makreed-dt/PLFM_RADAR/9_Firmware/9_2_FPGA/cic_decimator_4x_enhanced.v

module cic_decimator_4x_enhanced (
    input wire clk,                 // 400MHz input clock
    input wire reset_n,
    input wire signed [17:0] data_in,  // 18-bit input
    input wire data_valid,
    output reg signed [17:0] data_out, // 18-bit output
    output reg data_out_valid,       // Valid at 100MHz
    // Enhanced monitoring outputs
    output reg saturation_detected,  // Latched saturation indicator
    output reg [7:0] max_value_monitor, // For gain control
    input wire reset_monitors        // Clear saturation and max value
);

parameter STAGES = 5;
parameter DECIMATION = 4;
parameter COMB_DELAY = 1;

// Accumulator width: DSP48E1 native 48-bit.
// CIC uses modular (wrapping) arithmetic so extra MSBs are harmless.
localparam ACC_WIDTH = 48;

// Comb section operates on 28-bit (18 + 5*log2(4) = 28, exact for comb range).
localparam COMB_WIDTH = 28;

// ============================================================================
// INTEGRATOR CHAIN — explicit DSP48E1 with PCOUT→PCIN cascade
// ============================================================================
// Integrator[0]: P = P + C,    C = sign_extend(data_in)  [from fabric]
// Integrator[k]: P = P + PCIN, PCIN from integrator[k-1] [dedicated cascade]
//
// The PCOUT→PCIN cascade uses dedicated silicon routing between vertically
// adjacent DSP48E1 tiles — zero fabric delay, guaranteed to meet 400+ MHz
// on 7-series regardless of speed grade.
//
// Active-high reset derived from reset_n (inverted).
// CEP (clock enable for P register) gated by data_valid.
// ============================================================================

wire reset_h = ~reset_n;  // active-high reset for DSP48E1 RSTP

// Sign-extended input for integrator_0 C port (48-bit)
wire [ACC_WIDTH-1:0] data_in_c = {{(ACC_WIDTH-18){data_in[17]}}, data_in};

// DSP48E1 cascade wires
wire [47:0] pcout_0, pcout_1, pcout_2, pcout_3;
wire [47:0] p_out_0, p_out_1, p_out_2, p_out_3, p_out_4;

`ifndef SIMULATION
// ============================================================================
// SYNTHESIS: Explicit DSP48E1 instances with PCOUT→PCIN cascade
// ============================================================================

// --- Integrator 0: P = P + C (accumulate sign-extended input) ---
// OPMODE = 7'b0101100: Z=P(010), Y=C(11), X=0(00) → P = P + C
// CREG=1: C port is registered inside DSP48E1. This eliminates the
// fabric→DSP C-port setup timing violation (-0.415ns in Build 6).
// The CREG adds 1 cycle of latency before data reaches the ALU.
// CEC=data_valid gates the C register to match CEP behavior.
DSP48E1 #(
    .A_INPUT            ("DIRECT"),
    .B_INPUT            ("DIRECT"),
    .USE_DPORT          ("FALSE"),
    .USE_MULT           ("NONE"),
    .AUTORESET_PATDET   ("NO_RESET"),
    .MASK               (48'h3FFFFFFFFFFF),
    .PATTERN             (48'h000000000000),
    .SEL_MASK           ("MASK"),
    .SEL_PATTERN        ("PATTERN"),
    .USE_PATTERN_DETECT ("NO_PATDET"),
    .ACASCREG           (0),
    .ADREG              (0),
    .ALUMODEREG         (0),
    .AREG               (0),
    .BCASCREG           (0),
    .BREG               (0),
    .CARRYINREG         (0),
    .CARRYINSELREG      (0),
    .CREG               (1),       // C port registered inside DSP — eliminates fabric→DSP setup path
    .DREG               (0),
    .INMODEREG          (0),
    .MREG               (0),
    .OPMODEREG          (0),
    .PREG               (1)        // P register enabled (accumulator)
) integrator_0_dsp (
    .CLK                (clk),
    .A                  (30'd0),
    .B                  (18'd0),
    .C                  (data_in_c),
    .D                  (25'd0),
    .CARRYIN            (1'b0),
    .CARRYINSEL         (3'b000),
    .OPMODE             (7'b0101100),  // P = P + C
    .ALUMODE            (4'b0000),     // Z + (X + Y + CIN)
    .INMODE             (5'b00000),
    .CEA1               (1'b0),
    .CEA2               (1'b0),
    .CEB1               (1'b0),
    .CEB2               (1'b0),
    .CEC                (data_valid),  // Register C when data is valid (CREG=1)
    .CED                (1'b0),
    .CEM                (1'b0),
    .CEP                (data_valid),  // Accumulate only when data is valid
    .CEAD               (1'b0),
    .CEALUMODE          (1'b0),
    .CECTRL             (1'b0),
    .CECARRYIN          (1'b0),
    .CEINMODE           (1'b0),
    .RSTP               (reset_h),
    .RSTA               (1'b0),
    .RSTB               (1'b0),
    .RSTC               (reset_h),     // Reset C register (CREG=1) on reset
    .RSTD               (1'b0),
    .RSTM               (1'b0),
    .RSTALLCARRYIN      (1'b0),
    .RSTALUMODE         (1'b0),
    .RSTCTRL            (1'b0),
    .RSTINMODE          (1'b0),
    .P                  (p_out_0),
    .PCOUT              (pcout_0),
    .ACOUT              (),
    .BCOUT              (),
    .CARRYCASCOUT       (),
    .CARRYOUT           (),
    .MULTSIGNOUT        (),
    .OVERFLOW           (),
    .PATTERNBDETECT     (),
    .PATTERNDETECT      (),
    .UNDERFLOW          ()
);

// --- Integrator 1: P = P + PCIN (cascade from integrator_0) ---
// OPMODE = 7'b0010010: Z=PCIN(001), Y=0(00), X=P(10) → P = P + PCIN
DSP48E1 #(
    .A_INPUT            ("DIRECT"),
    .B_INPUT            ("DIRECT"),
    .USE_DPORT          ("FALSE"),
    .USE_MULT           ("NONE"),
    .AUTORESET_PATDET   ("NO_RESET"),
    .MASK               (48'h3FFFFFFFFFFF),
    .PATTERN             (48'h000000000000),
    .SEL_MASK           ("MASK"),
    .SEL_PATTERN        ("PATTERN"),
    .USE_PATTERN_DETECT ("NO_PATDET"),
    .ACASCREG           (0),
    .ADREG              (0),
    .ALUMODEREG         (0),
    .AREG               (0),
    .BCASCREG           (0),
    .BREG               (0),
    .CARRYINREG         (0),
    .CARRYINSELREG      (0),
    .CREG               (0),
    .DREG               (0),
    .INMODEREG          (0),
    .MREG               (0),
    .OPMODEREG          (0),
    .PREG               (1)
) integrator_1_dsp (
    .CLK                (clk),
    .A                  (30'd0),
    .B                  (18'd0),
    .C                  (48'd0),
    .D                  (25'd0),
    .PCIN               (pcout_0),
    .CARRYIN            (1'b0),
    .CARRYINSEL         (3'b000),
    .OPMODE             (7'b0010010),  // P = P + PCIN
    .ALUMODE            (4'b0000),
    .INMODE             (5'b00000),
    .CEA1               (1'b0),
    .CEA2               (1'b0),
    .CEB1               (1'b0),
    .CEB2               (1'b0),
    .CEC                (1'b0),
    .CED                (1'b0),
    .CEM                (1'b0),
    .CEP                (data_valid),
    .CEAD               (1'b0),
    .CEALUMODE          (1'b0),
    .CECTRL             (1'b0),
    .CECARRYIN          (1'b0),
    .CEINMODE           (1'b0),
    .RSTP               (reset_h),
    .RSTA               (1'b0),
    .RSTB               (1'b0),
    .RSTC               (1'b0),
    .RSTD               (1'b0),
    .RSTM               (1'b0),
    .RSTALLCARRYIN      (1'b0),
    .RSTALUMODE         (1'b0),
    .RSTCTRL            (1'b0),
    .RSTINMODE          (1'b0),
    .P                  (p_out_1),
    .PCOUT              (pcout_1),
    .ACOUT              (),
    .BCOUT              (),
    .CARRYCASCOUT       (),
    .CARRYOUT           (),
    .MULTSIGNOUT        (),
    .OVERFLOW           (),
    .PATTERNBDETECT     (),
    .PATTERNDETECT      (),
    .UNDERFLOW          ()
);

// --- Integrator 2: P = P + PCIN (cascade from integrator_1) ---
DSP48E1 #(
    .A_INPUT            ("DIRECT"),
    .B_INPUT            ("DIRECT"),
    .USE_DPORT          ("FALSE"),
    .USE_MULT           ("NONE"),
    .AUTORESET_PATDET   ("NO_RESET"),
    .MASK               (48'h3FFFFFFFFFFF),
    .PATTERN             (48'h000000000000),
    .SEL_MASK           ("MASK"),
    .SEL_PATTERN        ("PATTERN"),
    .USE_PATTERN_DETECT ("NO_PATDET"),
    .ACASCREG           (0),
    .ADREG              (0),
    .ALUMODEREG         (0),
    .AREG               (0),
    .BCASCREG           (0),
    .BREG               (0),
    .CARRYINREG         (0),
    .CARRYINSELREG      (0),
    .CREG               (0),
    .DREG               (0),
    .INMODEREG          (0),
    .MREG               (0),
    .OPMODEREG          (0),
    .PREG               (1)
) integrator_2_dsp (
    .CLK                (clk),
    .A                  (30'd0),
    .B                  (18'd0),
    .C                  (48'd0),
    .D                  (25'd0),
    .PCIN               (pcout_1),
    .CARRYIN            (1'b0),
    .CARRYINSEL         (3'b000),
    .OPMODE             (7'b0010010),  // P = P + PCIN
    .ALUMODE            (4'b0000),
    .INMODE             (5'b00000),
    .CEA1               (1'b0),
    .CEA2               (1'b0),
    .CEB1               (1'b0),
    .CEB2               (1'b0),
    .CEC                (1'b0),
    .CED                (1'b0),
    .CEM                (1'b0),
    .CEP                (data_valid),
    .CEAD               (1'b0),
    .CEALUMODE          (1'b0),
    .CECTRL             (1'b0),
    .CECARRYIN          (1'b0),
    .CEINMODE           (1'b0),
    .RSTP               (reset_h),
    .RSTA               (1'b0),
    .RSTB               (1'b0),
    .RSTC               (1'b0),
    .RSTD               (1'b0),
    .RSTM               (1'b0),
    .RSTALLCARRYIN      (1'b0),
    .RSTALUMODE         (1'b0),
    .RSTCTRL            (1'b0),
    .RSTINMODE          (1'b0),
    .P                  (p_out_2),
    .PCOUT              (pcout_2),
    .ACOUT              (),
    .BCOUT              (),
    .CARRYCASCOUT       (),
    .CARRYOUT           (),
    .MULTSIGNOUT        (),
    .OVERFLOW           (),
    .PATTERNBDETECT     (),
    .PATTERNDETECT      (),
    .UNDERFLOW          ()
);

// --- Integrator 3: P = P + PCIN (cascade from integrator_2) ---
DSP48E1 #(
    .A_INPUT            ("DIRECT"),
    .B_INPUT            ("DIRECT"),
    .USE_DPORT          ("FALSE"),
    .USE_MULT           ("NONE"),
    .AUTORESET_PATDET   ("NO_RESET"),
    .MASK               (48'h3FFFFFFFFFFF),
    .PATTERN             (48'h000000000000),
    .SEL_MASK           ("MASK"),
    .SEL_PATTERN        ("PATTERN"),
    .USE_PATTERN_DETECT ("NO_PATDET"),
    .ACASCREG           (0),
    .ADREG              (0),
    .ALUMODEREG         (0),
    .AREG               (0),
    .BCASCREG           (0),
    .BREG               (0),
    .CARRYINREG         (0),
    .CARRYINSELREG      (0),
    .CREG               (0),
    .DREG               (0),
    .INMODEREG          (0),
    .MREG               (0),
    .OPMODEREG          (0),
    .PREG               (1)
) integrator_3_dsp (
    .CLK                (clk),
    .A                  (30'd0),
    .B                  (18'd0),
    .C                  (48'd0),
    .D                  (25'd0),
    .PCIN               (pcout_2),
    .CARRYIN            (1'b0),
    .CARRYINSEL         (3'b000),
    .OPMODE             (7'b0010010),  // P = P + PCIN
    .ALUMODE            (4'b0000),
    .INMODE             (5'b00000),
    .CEA1               (1'b0),
    .CEA2               (1'b0),
    .CEB1               (1'b0),
    .CEB2               (1'b0),
    .CEC                (1'b0),
    .CED                (1'b0),
    .CEM                (1'b0),
    .CEP                (data_valid),
    .CEAD               (1'b0),
    .CEALUMODE          (1'b0),
    .CECTRL             (1'b0),
    .CECARRYIN          (1'b0),
    .CEINMODE           (1'b0),
    .RSTP               (reset_h),
    .RSTA               (1'b0),
    .RSTB               (1'b0),
    .RSTC               (1'b0),
    .RSTD               (1'b0),
    .RSTM               (1'b0),
    .RSTALLCARRYIN      (1'b0),
    .RSTALUMODE         (1'b0),
    .RSTCTRL            (1'b0),
    .RSTINMODE          (1'b0),
    .P                  (p_out_3),
    .PCOUT              (pcout_3),
    .ACOUT              (),
    .BCOUT              (),
    .CARRYCASCOUT       (),
    .CARRYOUT           (),
    .MULTSIGNOUT        (),
    .OVERFLOW           (),
    .PATTERNBDETECT     (),
    .PATTERNDETECT      (),
    .UNDERFLOW          ()
);

// --- Integrator 4: P = P + PCIN (cascade from integrator_3) ---
// No PCOUT needed (last stage in cascade)
DSP48E1 #(
    .A_INPUT            ("DIRECT"),
    .B_INPUT            ("DIRECT"),
    .USE_DPORT          ("FALSE"),
    .USE_MULT           ("NONE"),
    .AUTORESET_PATDET   ("NO_RESET"),
    .MASK               (48'h3FFFFFFFFFFF),
    .PATTERN             (48'h000000000000),
    .SEL_MASK           ("MASK"),
    .SEL_PATTERN        ("PATTERN"),
    .USE_PATTERN_DETECT ("NO_PATDET"),
    .ACASCREG           (0),
    .ADREG              (0),
    .ALUMODEREG         (0),
    .AREG               (0),
    .BCASCREG           (0),
    .BREG               (0),
    .CARRYINREG         (0),
    .CARRYINSELREG      (0),
    .CREG               (0),
    .DREG               (0),
    .INMODEREG          (0),
    .MREG               (0),
    .OPMODEREG          (0),
    .PREG               (1)
) integrator_4_dsp (
    .CLK                (clk),
    .A                  (30'd0),
    .B                  (18'd0),
    .C                  (48'd0),
    .D                  (25'd0),
    .PCIN               (pcout_3),
    .CARRYIN            (1'b0),
    .CARRYINSEL         (3'b000),
    .OPMODE             (7'b0010010),  // P = P + PCIN
    .ALUMODE            (4'b0000),
    .INMODE             (5'b00000),
    .CEA1               (1'b0),
    .CEA2               (1'b0),
    .CEB1               (1'b0),
    .CEB2               (1'b0),
    .CEC                (1'b0),
    .CED                (1'b0),
    .CEM                (1'b0),
    .CEP                (data_valid),
    .CEAD               (1'b0),
    .CEALUMODE          (1'b0),
    .CECTRL             (1'b0),
    .CECARRYIN          (1'b0),
    .CEINMODE           (1'b0),
    .RSTP               (reset_h),
    .RSTA               (1'b0),
    .RSTB               (1'b0),
    .RSTC               (1'b0),
    .RSTD               (1'b0),
    .RSTM               (1'b0),
    .RSTALLCARRYIN      (1'b0),
    .RSTALUMODE         (1'b0),
    .RSTCTRL            (1'b0),
    .RSTINMODE          (1'b0),
    .P                  (p_out_4),
    .PCOUT              (),
    .ACOUT              (),
    .BCOUT              (),
    .CARRYCASCOUT       (),
    .CARRYOUT           (),
    .MULTSIGNOUT        (),
    .OVERFLOW           (),
    .PATTERNBDETECT     (),
    .PATTERNDETECT      (),
    .UNDERFLOW          ()
);

`else
// ============================================================================
// SIMULATION: Behavioral model (Icarus Verilog compatible)
// ============================================================================
// Functionally identical: each integrator is P <= P + input, gated by data_valid.
// integrator_0 adds sign-extended data_in; stages 1-4 add previous stage output.
//
// CREG=1 on integrator_0: The C-port register adds 1 cycle of latency.
// data_in_c_delayed models this: on cycle N with data_valid, the DSP's C register
// captures data_in_c(N), but the ALU uses the PREVIOUS C register value.
// So sim_int_0 accumulates data_in_c_delayed (1 cycle behind data_in_c).
// ============================================================================
reg signed [ACC_WIDTH-1:0] sim_int_0, sim_int_1, sim_int_2, sim_int_3, sim_int_4;
reg signed [ACC_WIDTH-1:0] data_in_c_delayed;  // Models CREG=1 on integrator_0

always @(posedge clk) begin
    if (reset_h) begin
        sim_int_0 <= 0;
        sim_int_1 <= 0;
        sim_int_2 <= 0;
        sim_int_3 <= 0;
        sim_int_4 <= 0;
        data_in_c_delayed <= 0;
    end else if (data_valid) begin
        // CREG pipeline: capture current data, use previous
        data_in_c_delayed <= $signed(data_in_c);
        sim_int_0 <= sim_int_0 + data_in_c_delayed;
        sim_int_1 <= sim_int_1 + sim_int_0;
        sim_int_2 <= sim_int_2 + sim_int_1;
        sim_int_3 <= sim_int_3 + sim_int_2;
        sim_int_4 <= sim_int_4 + sim_int_3;
    end
end

assign p_out_0 = sim_int_0;
assign p_out_1 = sim_int_1;
assign p_out_2 = sim_int_2;
assign p_out_3 = sim_int_3;
assign p_out_4 = sim_int_4;
// pcout wires unused in simulation
assign pcout_0 = sim_int_0;
assign pcout_1 = sim_int_1;
assign pcout_2 = sim_int_2;
assign pcout_3 = sim_int_3;
`endif

// ============================================================================
// CONTROL AND MONITORING (fabric logic)
// ============================================================================
(* keep = "true", dont_touch = "true" *) reg signed [COMB_WIDTH-1:0] integrator_sampled;
(* keep = "true", dont_touch = "true", max_fanout = 1 *) reg signed [COMB_WIDTH-1:0] integrator_sampled_comb;
(* use_dsp = "yes" *) reg signed [COMB_WIDTH-1:0] comb [0:STAGES-1];
reg signed [COMB_WIDTH-1:0] comb_delay [0:STAGES-1][0:COMB_DELAY-1];

// Enhanced control and monitoring
reg [1:0] decimation_counter;
(* keep = "true", max_fanout = 4 *) reg data_valid_delayed;
(* keep = "true", max_fanout = 4 *) reg data_valid_comb;
(* keep = "true", max_fanout = 4 *) reg data_valid_comb_pipe;
reg [7:0] output_counter;
reg [ACC_WIDTH-1:0] max_integrator_value;
reg overflow_detected;
reg overflow_latched;

// Diagnostic registers
reg [7:0] saturation_event_count;
reg [31:0] sample_count;

// Comb-stage saturation flags
reg comb_overflow_latched;
reg comb_saturation_detected;
reg [7:0] comb_saturation_event_count;

// Temporary signals for calculations
reg signed [ACC_WIDTH-1:0] abs_integrator_value;
reg signed [COMB_WIDTH-1:0] temp_scaled_output;
reg signed [17:0] temp_output;

// Pipeline stage for saturation comparison
reg sat_pos;
reg sat_neg;
reg signed [17:0] temp_output_pipe;
reg data_out_valid_pipe;

integer i, j;

// Initialize
initial begin
    for (i = 0; i < STAGES; i = i + 1) begin
        comb[i] = 0;
        for (j = 0; j < COMB_DELAY; j = j + 1) begin
            comb_delay[i][j] = 0;
        end
    end
    integrator_sampled = 0;
    decimation_counter = 0;
    data_valid_delayed = 0;
    data_valid_comb = 0;
    data_valid_comb_pipe = 0;
    output_counter = 0;
    max_integrator_value = 0;
    overflow_detected = 0;
    overflow_latched = 0;
    saturation_detected = 0;
    saturation_event_count = 0;
    sample_count = 0;
    max_value_monitor = 0;
    data_out = 0;
    data_out_valid = 0;
    abs_integrator_value = 0;
    temp_scaled_output = 0;
    temp_output = 0;
    sat_pos = 0;
    sat_neg = 0;
    temp_output_pipe = 0;
    data_out_valid_pipe = 0;
    comb_overflow_latched = 0;
    comb_saturation_detected = 0;
    comb_saturation_event_count = 0;
end

// Decimation control + monitoring (integrators are now DSP48E1 instances)
// Sync reset: enables FDRE inference for better timing at 400 MHz.
// Reset is already synchronous to clk via reset synchronizer in parent module.
always @(posedge clk) begin
    if (!reset_n) begin
        integrator_sampled <= 0;
        decimation_counter <= 0;
        data_valid_delayed <= 0;
        max_integrator_value <= 0;
        overflow_detected <= 0;
        sample_count <= 0;
        abs_integrator_value <= 0;
        overflow_latched <= 0;
        saturation_detected <= 0;
        saturation_event_count <= 0;
        max_value_monitor <= 0;
        output_counter <= 0;
    end else begin
        // Monitor control
        if (reset_monitors) begin
            overflow_latched <= 0;
            saturation_detected <= 0;
            max_integrator_value <= 0;
            max_value_monitor <= 0;
            saturation_event_count <= 0;
        end

        if (data_valid) begin
            sample_count <= sample_count + 1;

            // Monitor integrator_0 magnitude (read DSP P output)
            abs_integrator_value <= (p_out_0[ACC_WIDTH-1]) ? -$signed(p_out_0) : $signed(p_out_0);

            if (abs_integrator_value > max_integrator_value) begin
                max_integrator_value <= abs_integrator_value;
                max_value_monitor <= abs_integrator_value[27:20];
            end

            // Decimation control
            if (decimation_counter == DECIMATION - 1) begin
                decimation_counter <= 0;
                data_valid_delayed <= 1;
                output_counter <= output_counter + 1;
                // Capture integrator_4 output, truncate to comb width
                integrator_sampled <= p_out_4[COMB_WIDTH-1:0];
            end else begin
                decimation_counter <= decimation_counter + 1;
                data_valid_delayed <= 0;
            end
        end else begin
            data_valid_delayed <= 0;
            overflow_detected <= 1'b0;
        end
    end
end

// Pipeline the valid signal for comb section
// Sync reset: matches decimation control block reset style.
always @(posedge clk) begin
    if (!reset_n) begin
        data_valid_comb <= 0;
        data_valid_comb_pipe <= 0;
        integrator_sampled_comb <= 0;
    end else begin
        data_valid_comb <= data_valid_delayed;
        data_valid_comb_pipe <= data_valid_comb;
        integrator_sampled_comb <= integrator_sampled;
    end
end

// Enhanced comb section with scaling and saturation monitoring
// Sync reset: converts FDCE → FDRE for all comb registers. This eliminates
// async-clear routing overhead and enables DSP48E1 absorption of the 28-bit
// subtracts via Vivado's use_dsp inference. The comb subtraction was the
// design-wide critical path in Build 9 (8 logic levels of CARRY4 at 400 MHz,
// WNS = +0.128ns). DSP48E1 ALU performs 48-bit add/subtract in a single
// cycle with zero fabric logic, targeting WNS > +1.0ns.
//
// The (* use_dsp = "yes" *) attribute on comb[] tells Vivado synthesis to
// map the subtract into DSP48E1 P = C - A:B (ALUMODE=4'b0011). Each comb
// stage becomes one DSP48E1 with PREG=1, completely eliminating the CARRY4
// chain from fabric. With 5 stages × 2 channels (I/Q) = 10 additional
// DSP48E1s, total DSP usage rises from 130 to ~140 out of 740 (18.9%).

always @(posedge clk) begin
    if (!reset_n) begin
        for (i = 0; i < STAGES; i = i + 1) begin
            comb[i] <= 0;
            for (j = 0; j < COMB_DELAY; j = j + 1) begin
                comb_delay[i][j] <= 0;
            end
        end
        data_out <= 0;
        data_out_valid <= 0;
        temp_scaled_output <= 0;
        temp_output <= 0;
        sat_pos <= 0;
        sat_neg <= 0;
        temp_output_pipe <= 0;
        data_out_valid_pipe <= 0;
        comb_overflow_latched <= 0;
        comb_saturation_detected <= 0;
        comb_saturation_event_count <= 0;
    end else begin
        if (reset_monitors) begin
            comb_overflow_latched <= 0;
            comb_saturation_detected <= 0;
            comb_saturation_event_count <= 0;
        end

        if (data_valid_comb_pipe) begin
            for (i = 0; i < STAGES; i = i + 1) begin
                if (i == 0) begin
                    comb[0] <= integrator_sampled_comb - comb_delay[0][COMB_DELAY-1];
                    for (j = COMB_DELAY-1; j > 0; j = j - 1) begin
                        comb_delay[0][j] <= comb_delay[0][j-1];
                    end
                    comb_delay[0][0] <= integrator_sampled_comb;
                end else begin
                    comb[i] <= comb[i-1] - comb_delay[i][COMB_DELAY-1];
                    for (j = COMB_DELAY-1; j > 0; j = j - 1) begin
                        comb_delay[i][j] <= comb_delay[i][j-1];
                    end
                    comb_delay[i][0] <= comb[i-1];
                end
            end

            // Gain = (4^5) = 1024 = 2^10, scale by 2^10 to normalize
            temp_scaled_output <= comb[STAGES-1] >>> 10;
            temp_output <= temp_scaled_output[17:0];

            // Pipeline Stage 2: Register saturation comparison flags
            sat_pos <= (temp_scaled_output > 131071);
            sat_neg <= (temp_scaled_output < -131072);
            temp_output_pipe <= temp_scaled_output[17:0];
            data_out_valid_pipe <= 1;
        end else begin
            data_out_valid_pipe <= 0;
        end

        // Pipeline Stage 3: MUX from registered comparison flags
        if (data_out_valid_pipe) begin
            if (sat_pos) begin
                data_out <= 131071;
                comb_overflow_latched <= 1'b1;
                comb_saturation_detected <= 1'b1;
                comb_saturation_event_count <= comb_saturation_event_count + 1;
                `ifdef SIMULATION
                $display("CIC_OUTPUT_SAT: TRUE Positive saturation, final_out=%d", 131071);
                `endif
            end else if (sat_neg) begin
                data_out <= -131072;
                comb_overflow_latched <= 1'b1;
                comb_saturation_detected <= 1'b1;
                comb_saturation_event_count <= comb_saturation_event_count + 1;
                `ifdef SIMULATION
                $display("CIC_OUTPUT_SAT: TRUE Negative saturation, final_out=%d", -131072);
                `endif
            end else begin
                data_out <= temp_output_pipe;
                comb_overflow_latched <= 1'b0;
                comb_saturation_detected <= 1'b0;
            end

            data_out_valid <= 1;
        end else begin
            data_out_valid <= 0;
        end
    end
end

// Continuous monitoring
`ifdef SIMULATION
always @(posedge clk) begin
    if (overflow_detected && sample_count < 100) begin
        $display("CIC_OVERFLOW: Immediate detection at sample %0d", sample_count);
    end
end
`endif

endmodule
