makreed-dt/PLFM_RADAR/(commit log)

2026-03-15 Achieve timing closure: DSP48E1 pipelines, 4-stage NCO, 28-bit CIC, ASYNC_REG
    Phase 0+ timing optimization (attempts #13-22 + implementation):
    NCO (nco_400m_enhanced.v):
    - 4-stage pipeline: DSP48E1 accumulate -> LUT read -> negate -> quadrant MUX
    - DSP48E1 phase accumulator in P=P+C mode (eliminates 8-stage CARRY4 chain)
    - Registered phase_inc_dithered to break cascaded 32-bit add path
    DDC (ddc_400m.v):
    - Direct DSP48E1 instantiation for I/Q mixers (AREG=1, BREG=1, MREG=1, PREG=1)
    - CEP=1, RSTP=!reset_n for proper pipeline control
    - 3-stage dsp_valid_pipe for PREG=1 latency
    - Behavioral sim model under ifdef SIMULATION for Icarus compatibility
    CIC (cic_decimator_4x_enhanced.v):
    - 28-bit a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
    [cic_dc_output.csv, cic_impulse_output.csv, cic_sine_passband.csv, ddc_120mhz_output.csv, nco_120mhz_output.csv, nco_1mhz_output.csv, nco_freq_switch.csv, nco_quadrature.csv]
2026-03-17 Fix CDC reset domain bug (P0), strengthen testbenches with 31 structural assertions
    Split cdc_adc_to_processing reset_n into src_reset_n/dst_reset_n so source
    and destination clock domains use correctly-synchronized resets. Previously
    cdc_chirp_counter's destination-side sync chain (100MHz) was reset by
    sys_reset_120m_n (120MHz domain), causing 30 CDC critical warnings.
    RTL changes:
    - cdc_modules.v: split reset port, source logic uses src_reset_n,
    destination sync chains + output logic use dst_reset_n
    - radar_system_top.v: cdc_chirp_counter gets proper per-domain resets
    - ddc_400m.v: CDC_FIR_i/q use reset_n_400m (src) and reset_n (dst)
    - formal/fv_cdc_adc.v: updated wrapper for new port i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
    [rx_final_doppler_out.csv]
2026-03-19 CIC comb pipeline registers, BUFG sim guard, system TB fix, regression runner
    - cic_decimator_4x_enhanced.v: Add integrator_sampled_comb and
    data_valid_comb_pipe pipeline stages between integrator sampling and
    comb computation to break the critical path (matches remote 40cda0f)
    - radar_system_top.v: Wrap 3 BUFG instances in ifdef SIMULATION guard
    with pass-through assigns for iverilog compatibility
    - radar_system_tb.v: Convert generate_radar_echo function to task and
    move sin_lut declaration before task (iverilog declaration-order fix),
    add modular index clamping to prevent LUT out-of-bounds
    - run_regression.sh: Automated regression runner for all 18 FPGA
    testbenches with --quick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
    [rx_final_doppler_out.csv]
2026-03-19 Add FMC-path FT601 XDC for TE0713+TE0701+UMFT601X-B pin mapping
    Maps all 47 FT601 signals through FMC LPC J10 to correct FPGA pins:
    - DATA[31:0] + D_CLK: Bank 15 (LA17-LA33)
    - BE_N[3:0], control, status: Bank 16 (LA00-LA15)
    Both banks share VIOTB rail — set to 3.3V for LVCMOS33.
    Includes timing constraints and RTL adaptation notes.
    [te0713_te0701_umft601x.xdc]
2026-04-07 refactor(host): remove FT601 support from radar_protocol.py
    Strip all FT601/ftd3xx references from the core protocol module:
    - Remove FT601Connection class and ftd3xx import block
    - Remove _build_packets_ft601() 35-byte packet builder
    - Remove compact: bool parameter from RadarAcquisition
    - Remove dual-path parsing logic (compact vs FT601)
    - Rename parse_data_packet_compact -> parse_data_packet
    - Unify DATA_PACKET_SIZE to single 11-byte constant
    The 50T production board uses FT2232H exclusively.
    FT601 remains in out-of-scope legacy files (GUI_V6, etc).
